natngu-umich/GVS/ltspice/combined_analog.asc

A1: dflop; Vhigh=3.3 Vlow=0 Trise=10n Tfall=10n
A2: inv; Vhigh=3.3 Vlow=0 Trise=10n Tfall=10n
A3: inv; Vhigh=3.3 Vlow=0 Trise=10n Tfall=10n
C1: cap; 0.1µ
C2: cap; 0.1µ
C3: cap; 0.1µ
C4: cap; 0.1µ
C5: cap; 0.1µ
C6: cap; 10nF
C7: cap; 0.1µ
D1: LED
DAC: voltage; SINE(1.65 1.65 10)
R1: res; 50k
R2: res; 10k
R3: res; 50k
R4: res; 10k
R5: res; 10
R6: res; 10k
R7: res; 10k
R8: res; 10k
R9: res; 10k
R10: res; 100k
R11: res; 11.8
R12: res; 10k
R13: res; 100k
R14: res; 10k
R15: res; 10k
R16: res; 390
R17: res; 10k
R18: res; 10K
R19: res; 10k
R20: res; 10k
R21: res; 1000
Rload: res; 5k
Rsense: res; 100
S1: sw; switch
U1: LT1013
U2: LT1013
U3: LT1013
U4: LT1013
U5: INA303A1
U6: OPA313
U7: AQY210S
U8: OPA313
U9: OPA313
U10: BAS40
U11: CMJ3500
U12: BAS40
U13: BAS40
U14: BAS40
V1: voltage; 3.3
V3: voltage; PWL(0 0 0.04 0 0.0401 3.3 0.050 3.3 0.0501 0 0.16 0 0.1601 3.3 0.17 3.3 0.1701 0 0.2 0)
V4: voltage; 24.6
Named nets: 0, 24Volt, VCC, Sense+, Sense-, VREF, LIMIT1, LIMIT2, Safety+, Safety-, DAC, Not_Tripped, ARM, Tripped, Electrode+
.tran 0 0.2 0 startup
.lib ina303a1.lib
.lib opa313.lib
.model switch SW(Ron=0.1 Roff=1Meg Vt=0.5 Vh=0)
