natngu-umich/GVS/ltspice/Howland_Pump.asc

DAC: voltage; SINE(1.65 1.65 1)
R1: res; 50k
R2: res; 10k
R3: res; 50k
R4: res; 10k
R5: res; 10
R6: res; 10k
R7: res; 10k
R8: res; 10k
R9: res; 10k
R10: res; 100k
Rload: res; 5k
Rsense: res; 100
U1: LT1013
U2: LT1013
U3: LT1013
U4: LT1013
V4: voltage; 24.6
Vref: voltage; 1.65
Named nets: 0, 24Volt
.step param RL list 100 500 1k 2k 3k 4k 5k
.tran 5
