natngu-umich/GVS/ltspice/gvs_safety.asc

C1: cap; 0.1µ
C2: cap; 0.1µ
C3: cap; 0.1µ
C4: cap; 0.1µ
C5: cap; 0.1µ
D1: LED
Q1: npn; 2N3904
Q2: npn; 2N3904
R1: res; 11.8
R2: res; 1000
R4: res; 10k
R5: res; 100k
R6: res; 10k
R7: res; 10k
R8: res; 390
R9: res; 5k
R10: res; 3.3k
R11: res; 10k
R12: res; 10k
U1: INA303A1
U2: OPA313
U3: AQY210S
U4: OPA313
U5: OPA313
V1: voltage; 3.3
V2: voltage; PWL(0 3.3 0.04 3.3 0.0401 0 0.050 0 0.0501 3.3 0.16 3.3 0.1601 0 0.17 0 0.1701 3.3 0.2 3.3)
V3: voltage; 12
V4: voltage; PWL(0 0 .10 -24 0.2 0)
Named nets: 0, VCC, Sense+, Sense-, VREF, VLatch, LIMIT1, LIMIT2
.tran 0 0.2 0 startup
.lib ina303a1.lib
.lib opa313.lib
