natngu-umich/GVS/kicad/Balance_GVS/Battery&Charging.kicad_sch

## KiCad design kicad/Balance_GVS/Battery&Charging.kicad_sch (2026-10-16)

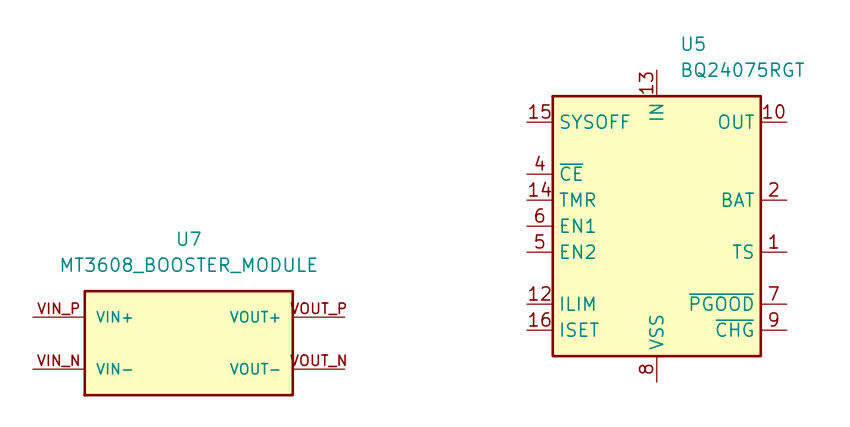
[picture p1: schematic Battery&Charging.kicad_sch]

Parts:
U5: BQ24075RGT; VQFN-16-1EP_3x3mm_P0.5mm_EP1.6x1.6mm
U7: MT3608_BOOSTER_MODULE; MT3608E

Connections:
unnamed: U5.2 (BAT), U5.3 (BAT)
unnamed: U5.10 (OUT), U5.11 (OUT)
unnamed: U5.8 (VSS), U5.17 (VSS)
