natngu-umich/GVS/kicad/Balance_GVS/Processor.kicad_sch

## KiCad design kicad/Balance_GVS/Processor.kicad_sch (2026-10-16)

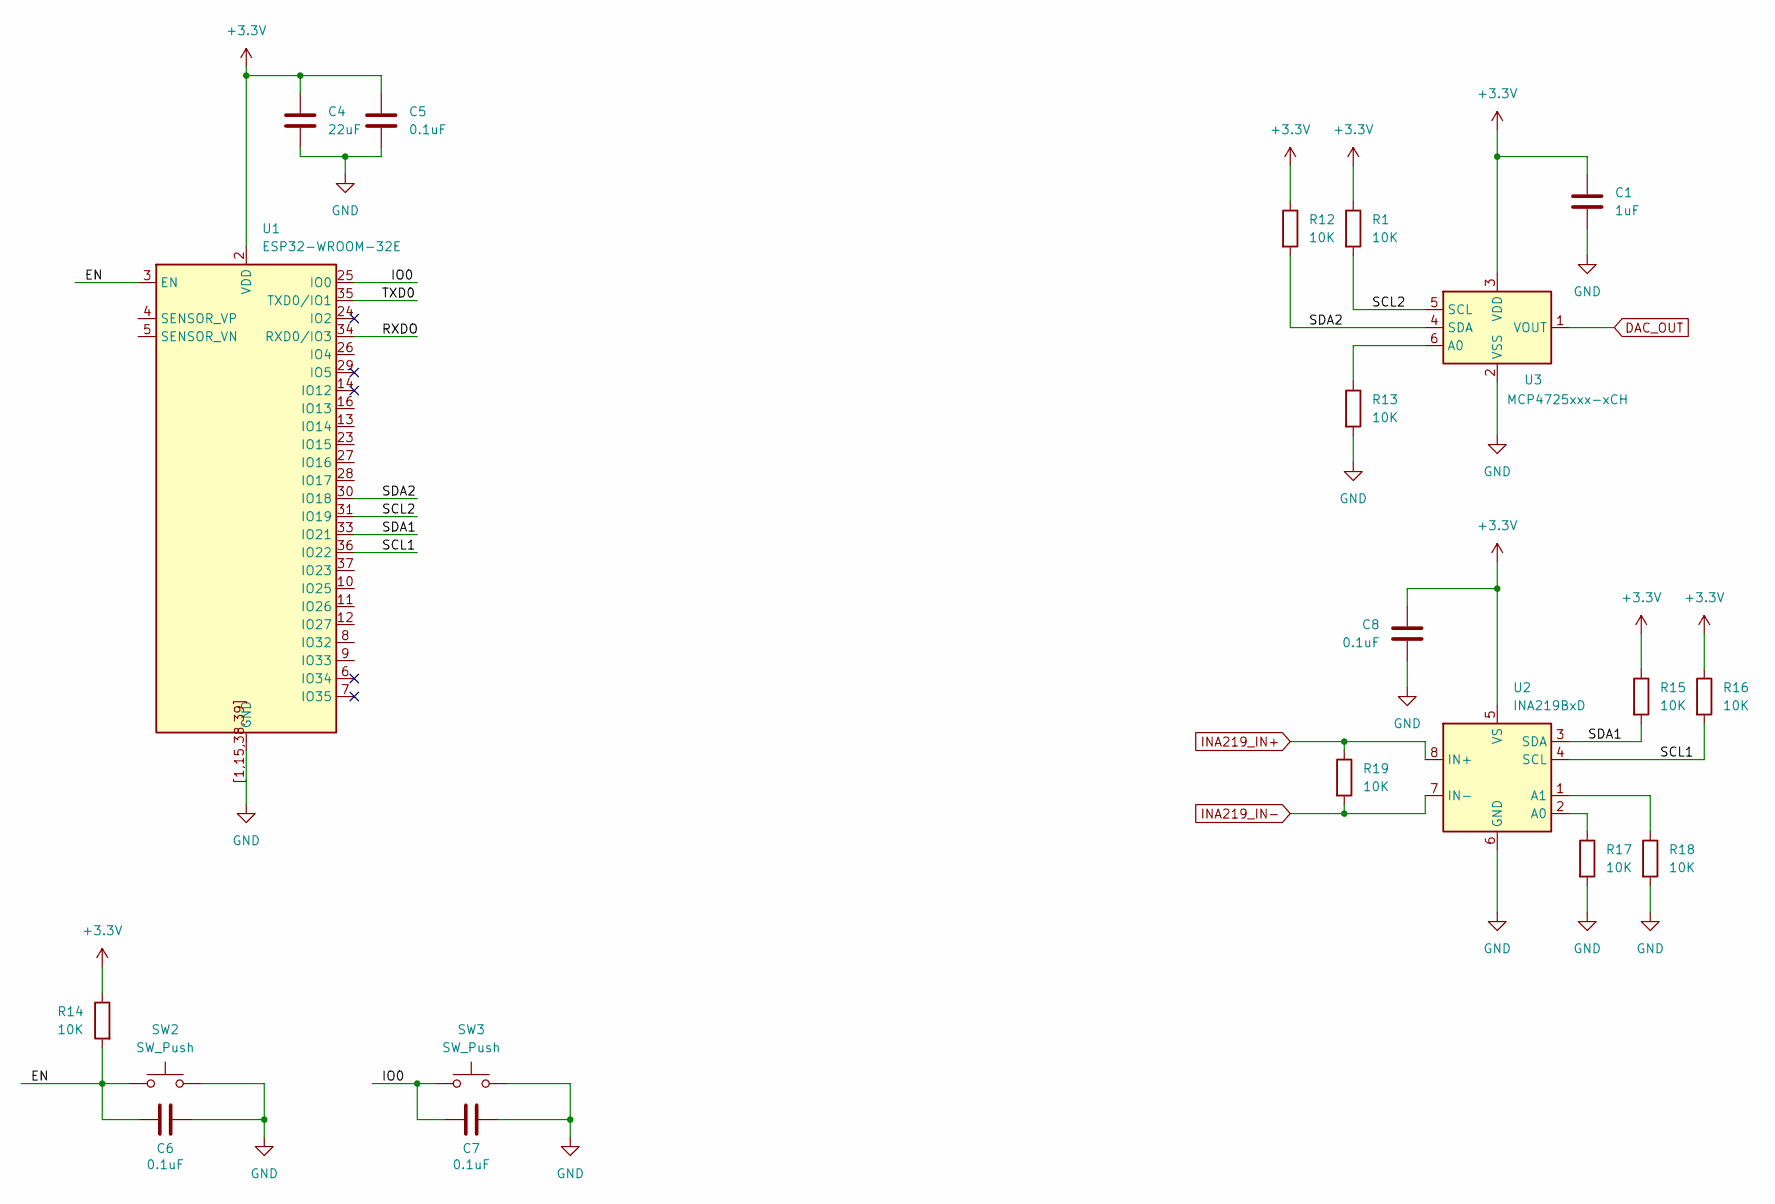
[picture p2: schematic Processor.kicad_sch]

Parts:
C1: 1uF
C4: 22uF
C5, C8: 0.1uF
C6, C7: 0.1uF; Balun_Johanson_0900PC15J0013
R1, R12, R13, R14, R15, R16, R17, R18, R19: 10K
SW2, SW3: SW_Push; ESP32-WROOM-32E
U1: ESP32-WROOM-32E
U2: INA219BxD; SOIC-8_3.9x4.9mm_P1.27mm
U3: MCP4725xxx-xCH; SOT-23-6

Connections:
+3.3V: C1.1, C4.1, C5.1, C8.1, R1.1, R12.1, R14.1, R15.1, R16.1, U1.2 (VDD), U2.5 (VS), U3.3 (VDD)
DAC_OUT: U3.1 (VOUT)
EN: C6.1, R14.2, SW2.2, U1.3 (EN)
GND: C1.2, C4.2, C5.2, C6.2, C7.2, C8.2, R13.2, R17.2, R18.2, SW2.1, SW3.1, U1.[1,15,38,39] (GND), U2.6 (GND), U3.2 (VSS)
INA219_IN+: R19.1, U2.8 (IN+)
INA219_IN-: R19.2, U2.7 (IN-)
IO0: C7.1, SW3.2, U1.25 (IO0)
unnamed: R13.1, U3.6 (A0)
unnamed: R17.1, U2.2 (A0)
unnamed: R18.1, U2.1 (A1)
RXDO: U1.34 (RXD0/IO3)
SCL1: R16.2, U1.36 (IO22), U2.4 (SCL)
SCL2: R1.2, U1.31 (IO19), U3.5 (SCL)
SDA1: R15.2, U1.33 (IO21), U2.3 (SDA)
SDA2: R12.2, U1.30 (IO18), U3.4 (SDA)
TXD0: U1.35 (TXD0/IO1)
