natngu-umich/GVS/kicad/Balance_GVS/Safety.kicad_sch

## KiCad design kicad/Balance_GVS/Safety.kicad_sch (2026-10-16)

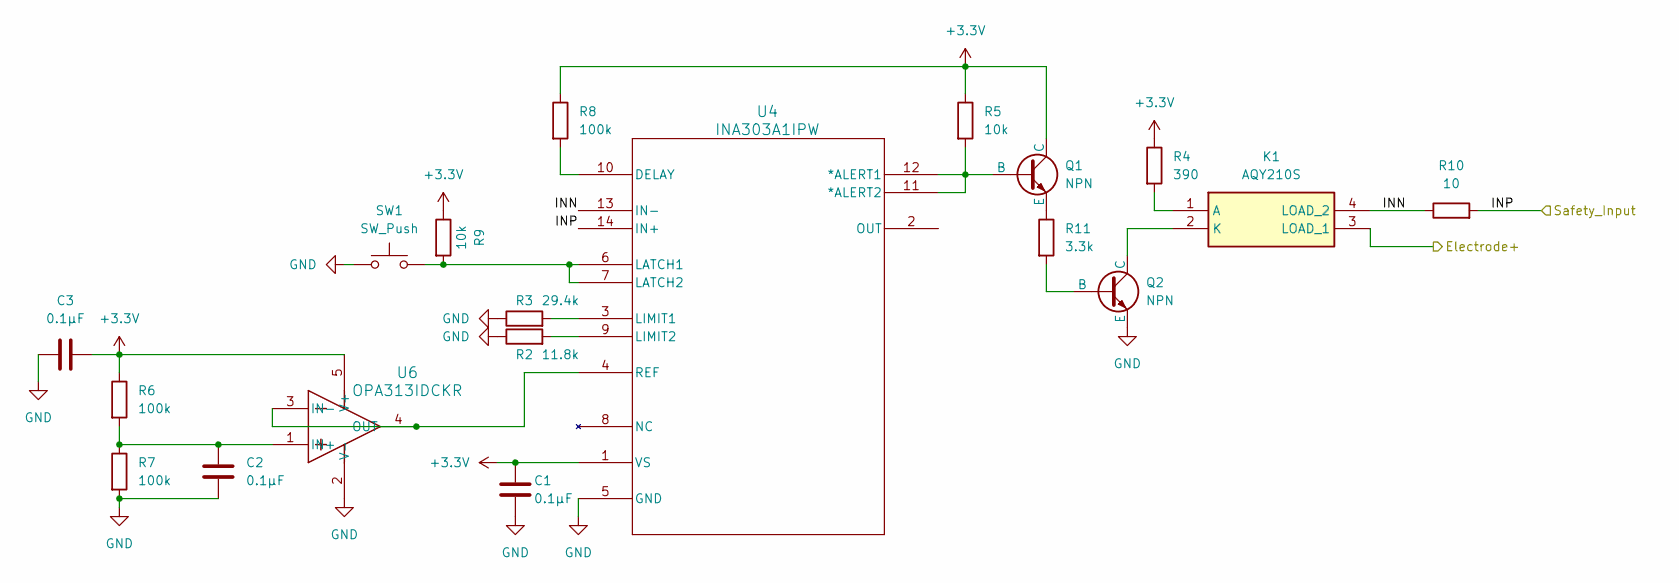
[picture p3: schematic Safety.kicad_sch]

Parts:
C1, C2, C3: 0.1µF
K1: AQY210S; SOP254P962X275-4N; Mouser Part Number 769-AQY210S
Q1, Q2: NPN
R2: 11.8k
R3: 29.4k
R4: 390
R5, R9: 10k
R6, R7, R8: 100k
R10: 10
R11: 3.3k
SW1: SW_Push
U4: INA303A1IPW; PW14_TEX
U6: OPA313IDCKR; DCK0005A_N

Connections:
+3.3V: C1.2, C3.2, Q1.1 (C), R4.1, R5.1, R6.1, R8.1, R9.1, U4.1 (VS), U6.5 (V+)
Electrode+: K1.3 (LOAD_1)
GND: C1.1, C2.2, C3.1, Q2.3 (E), R2.1, R3.1, R7.2, SW1.1, U4.5 (GND), U6.2 (V-)
INN: K1.4 (LOAD_2), R10.1, U4.13 (IN-)
INP: R10.2, U4.14 (IN+)
unnamed: C2.1, R6.2, R7.1, U6.1 (IN+)
unnamed: K1.1 (A), R4.2
unnamed: K1.2 (K), Q2.1 (C)
unnamed: Q1.2 (B), R5.2, U4.11 (*ALERT2), U4.12 (*ALERT1)
unnamed: Q1.3 (E), R11.1
unnamed: Q2.2 (B), R11.2
unnamed: R2.2, U4.9 (LIMIT2)
unnamed: R3.2, U4.3 (LIMIT1)
unnamed: R8.2, U4.10 (DELAY)
unnamed: R9.2, SW1.2, U4.6 (LATCH1), U4.7 (LATCH2)
unnamed: U4.4 (REF), U6.3 (IN-), U6.4 (OUT)
