natngu-umich/GVS/(commit log)

2026-10-08 Initial DAC and current sensor code
2026-10-12 Working Howland Current Pump
2026-10-13 KiCad PCB Files
2026-10-16 Add PCB to repo
2026-10-16 safety circuit change INA303 limit settting
2026-10-22 Better Howland Circuit
2026-10-23 Combined howland + safety circuit
2026-10-23 Add RC Filter for DAC
2026-10-24 Add current limiting diode bridge
2026-10-28 Cleaned up diode bridge footprints
2026-10-28 Add flip flop to safety circuit to change from level sensitive reset to positive edge reset
2026-11-02 Update INA219 with custom library for programmable shunt resistance
2026-11-04 BLE can control DAC and current sensor
2026-11-11 basic pcb io firmware
2026-11-12 Add basic DAC setting to pcb io FW
2026-11-13 Set DAC from potentiometer and add current sensor reading
2026-11-13 1 time program to set default DAC value to 1.65V
